zydusX3/CTv1/README.md

# CTv2
Cattle tracker v1: STM32WL (RAK3172) + LoRa + GPS + battery/solar collar tags, a home
beacon (LoRa → WiFi gateway) and a handheld beacon for finding animals in the field.

| Doc | Contents |
|---|---|
| [**Task list**](TASKS.md) | What's done, next and dropped. Updated as we go |
| [01 · System overview](docs/01-system-overview.md) | Block diagrams, radio settings, packet format, power budget |
| [02 · Collar tag](docs/02-hardware-collar-tag.md) | Schematic, BOM, firmware outline |
| [03 · Home beacon](docs/03-hardware-home-beacon.md) | Schematic, BOM, gateway software |
| [04 · Handheld beacon](docs/04-hardware-handheld.md) | Schematic, BOM, screen behaviour |
| [05 · Expansion](docs/05-expansion.md) | Add-ons for each device and the app |
| [06 · App requirements](docs/06-app-requirements.md) | Map, geofence and alert requirements, stack, data model |
| [UI mockup](app/mockup/index.html) | Open in a browser: Simple view (map only, big zoom buttons) and Advanced view (herd, alerts, fence editing) |
| [Hardware reference](hardware/README.md) | Plug-in ports, bench wiring, reference schematics and PCB placements for all three boards |
| [Firmware](firmware/README.md) | Collar tag, home beacon (RAK3172 radio + ESP32-S3 WiFi/MQTT) and handheld, shared library with unit tests, bench monitor |
