zydusX3/CTv1/hardware/beacon/netlist.csv

net | ref | pin
3V3 | C1 | 1
3V3 | C2 | 1
3V3 | J5 | 2 3V3
3V3 | J6 | 1 3V3
3V3 | M1 | 3V3 (out)
3V3 | R7 | 2
3V3 | R8 | 2
3V3 | TP1 | 3V3
3V3 | U1 | VDD
BOOT0 | J6 | 5 BOOT0
BOOT0 | R9 | 1
BOOT0 | U1 | BOOT0
GND | C1 | 2
GND | C2 | 2
GND | D1 | K
GND | D2 | K
GND | J1 | 2 GND
GND | J4 | 2 GND
GND | J5 | 1 GND
GND | J6 | 2 GND
GND | M1 | GND
GND | M2 | GND
GND | Q1 | S
GND | R2 | 2
GND | R6 | 2
GND | R9 | 2
GND | TP1 | GND
GND | U1 | GND
LED1_A | D1 | A
LED1_A | R3 | 2
LED2_A | D2 | A
LED2_A | R4 | 2
LED_ALARM | M1 | GPIO5
LED_ALARM | R4 | 1
LED_RX | M1 | GPIO4
LED_RX | R3 | 1
LINK_RX | M1 | GPIO18 RX1
LINK_RX | U1 | PB6 / TX1
LINK_TX | M1 | GPIO17 TX1
LINK_TX | U1 | PB7 / RX1
NRST | J6 | 6 NRST
NRST | M1 | GPIO16
NRST | U1 | RST
RADIO_IRQ | M1 | GPIO15
RADIO_IRQ | U1 | PA0
RX2 | J6 | 3 RX2
RX2 | U1 | PA3 / RX2
SCL | J5 | 3 SCL
SCL | M1 | GPIO9 SCL
SCL | R8 | 1
SDA | J5 | 4 SDA
SDA | M1 | GPIO8 SDA
SDA | R7 | 1
SIREN_EN | M1 | GPIO6
SIREN_EN | R5 | 1
SIREN_G | Q1 | G
SIREN_G | R5 | 2
SIREN_G | R6 | 1
SIREN_SW | D3 | A
SIREN_SW | J3 | 2 SW
SIREN_SW | Q1 | D
SWCLK | TP1 | SWCLK
SWCLK | U1 | PA14 SWCLK
SWDIO | TP1 | SWDIO
SWDIO | U1 | PA13 SWDIO
TX2 | J6 | 4 TX2
TX2 | U1 | PA2 / TX2
V12 | D3 | K
V12 | J3 | 1 V+
V12 | J4 | 1 V12
V5 | M1 | 5V
V5 | M2 | OUT+
VBUS_SENSE | M1 | GPIO1 ADC
VBUS_SENSE | R1 | 2
VBUS_SENSE | R2 | 1
VIN5 | J1 | 1 VBAT
VIN5 | M2 | IN+
VIN5 | R1 | 1
