zydusX3/CTv1/hardware/tag/netlist.csv

net | ref | pin
3V3 | C2 | 1
3V3 | C5 | 1
3V3 | C7 | 1
3V3 | D2 | K
3V3 | J3 | 1 3V3
3V3 | J4 | 1 3V3
3V3 | J5 | 1 V+
3V3 | R4 | 2
3V3 | R5 | 2
3V3 | R6 | 1
3V3 | TP1 | 3V3
3V3 | U1 | VDD
3V3 | U2 | VOUT
3V3 | U3 | VIN
ACC_INT | J3 | 5 INT
ACC_INT | U1 | PA0
BATT_SENSE | C3 | 1
BATT_SENSE | R1 | 2
BATT_SENSE | R2 | 1
BATT_SENSE | U1 | PB3 (ADC)
BOOT0 | J4 | 5 BOOT0
BOOT0 | R3 | 1
BOOT0 | U1 | BOOT0
BUZZ | R8 | 1
BUZZ | U1 | PB5
BUZZ_G | Q1 | G
BUZZ_G | R8 | 2
BUZZ_G | R9 | 1
BUZZ_SW | D2 | A
BUZZ_SW | J5 | 2 SW
BUZZ_SW | Q1 | D
GND | C1 | 2
GND | C2 | 2
GND | C3 | 2
GND | C4 | 2
GND | C5 | 2
GND | C6 | 2
GND | C7 | 2
GND | D1 | K
GND | J1 | 2 GND
GND | J2 | 2 GND
GND | J3 | 2 GND
GND | J4 | 2 GND
GND | Q1 | S
GND | R2 | 2
GND | R3 | 2
GND | R9 | 2
GND | TP1 | GND
GND | U1 | GND
GND | U2 | GND
GND | U3 | GND
GPS_EN | U1 | PA8
GPS_EN | U3 | ON
GPS_RXD | J2 | 4 RXD
GPS_RXD | U1 | PB6 / TX1
GPS_TXD | J2 | 3 TXD
GPS_TXD | U1 | PB7 / RX1
LED | R7 | 1
LED | U1 | PA1
LED_A | D1 | A
LED_A | R7 | 2
NRST | J4 | 6 NRST
NRST | U1 | RST
RX2 | J4 | 3 RX2
RX2 | U1 | PA3 / RX2
SCL | J3 | 4 SCL
SCL | R5 | 1
SCL | U1 | PA12 SCL
SDA | J3 | 3 SDA
SDA | R4 | 1
SDA | U1 | PA11 SDA
SWCLK | TP1 | SWCLK
SWCLK | U1 | PA14 SWCLK
SWDIO | TP1 | SWDIO
SWDIO | U1 | PA13 SWDIO
TX2 | J4 | 4 TX2
TX2 | U1 | PA2 / TX2
VBAT | C1 | 1
VBAT | J1 | 1 VBAT
VBAT | R1 | 1
VBAT | U2 | VIN
VBCKP | C4 | 1
VBCKP | J2 | 5 VBCKP
VBCKP | R6 | 2
VGPS | C6 | 1
VGPS | J2 | 1 VGPS
VGPS | U3 | VOUT
