zydusX3/CTv1/firmware/gateway_radio/config.h

#pragma once
// Home beacon radio. Farm key, frequency, SF and power must match the tags. These are defaults:
// set them with ATC+CTKEY / ATC+CTFREQ / ATC+CTSF / ATC+CTPWR on UART2 and they are kept in flash.
#define DEFAULT_FARM_KEY {0x43, 0x54, 0x76, 0x31, 0x2d, 0x63, 0x68, 0x61, 0x6e, 0x67, 0x65, 0x2d, 0x6d, 0x65, 0x21, 0x21}
#define DEFAULT_FREQ_HZ 865062500
#define DEFAULT_SF 10              // SF10: ~5 km with the roof antenna (SF9 ~2-4 km, SF11 for hills)
#define DEFAULT_TX_DBM 20          // India 865-867 MHz allows up to 1 W (30 dBm); use 14 in EU868

#define LORA_BW_KHZ 125
#define LORA_CR 0
#define LORA_PREAMBLE 8

#define ACK_DELAY_MS CTV1_ACK_DELAY_MS  // give the tag time to switch to receive after it finishes sending
#define MAX_TAGS 64          // tags remembered for duplicate detection and queued commands
#define STATUS_EVERY_MS 60000

// Where the line protocol goes (see lib/ctv1/src/ctv1_gwlink.h):
//   0 = UART1 (PB6/PB7) to the ESP32-S3, as in docs/03-hardware-home-beacon.md
//   1 = UART2, the USB programming port: plug the module into a PC and run tools/gw_monitor.py
//       (ATC+ commands are off in this mode; the defaults above are used unless set before)
#define LINK_ON_USB 1
#define LINK_BAUD 115200
