zydusX3/CTv1/(commit log)

2026-10-21 Add v1 design docs: block diagrams, schematics, expansion, app requirements and UI mockup
    Claude-Session: https://claude.ai/code/session_01JAYTGVegW8s75dPQkkojPH
2026-10-21 Add Simple view (map only, big zoom controls) with switch to Advanced view
    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
2026-10-21 Start firmware: shared CTv1 library with tests, collar tag and home beacon radio sketches
    - lib/ctv1: packet encode/decode with AES-CMAC MIC, per-tag keys derived
    from one farm key, NMEA GGA/RMC parser, geofence with hysteresis,
    battery curve, report scheduling, beacon UART line protocol
    - tag: GPS fix, LIS3DH motion count, uplink with ACK + one retry,
    buzz / interval / fast-track commands, RTC timer + sleep
    - gateway_radio: continuous RX, MIC check, duplicate detection,
    per-tag command queue, ACKs, text lines to ESP32 or PC
    - tools/gw_monitor.py: decode beacon output and send commands
    - test: 117 host checks incl. FIPS-197 and RFC 4493 vectors
    - docs: packet table and beacon UART wi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
    [config.h, gateway_radio.ino, gw_monitor.py, tag.ino]
2026-10-21 Home beacon ESP32-S3 firmware: WiFi setup, MQTT bridge, offline buffer, backup fence alarm
    - beacon_esp32: setup hotspot with captive settings page, MQTT publish of
    decoded reports / status / events, commands and retained fence from
    MQTT, 2000-report RAM buffer replayed with original timestamps,
    local fence check driving siren + red LED, BOOT button to silence,
    local web page with herd table and Buzz buttons, radio watchdog,
    mains power monitor
    - lib/ctv1: JSON for MQTT (report, command, fence) with host tests
    (153 checks)
    - docs: MQTT topic table and beacon software section match the code
    Claude-Session: https://claude.ai/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
    [beacon.h, beacon_esp32.ino, config.h, herd.cpp, mqtt.cpp, radio.cpp, settings.cpp]
2026-10-21 Map UI: full daily route in Simple view, double-tap zoom
    - Simple view: tapping a cow draws its whole route for today with
    2-hour time marks, a start marker and a card with distance walked
    - Advanced view: selected cow shows the full day, distance walked in
    its card; All trails shows everyone's last 2 h
    - Double-tap zooms in (pinch and one-finger pan already worked)
    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
2026-10-21 Firmware: settings in flash, GPS power saving, handheld beacon
    - Settings (ID, farm key, frequency, SF, power, interval, compass
    calibration) kept in RAK3172 flash with CRC; ATC+CT* commands set them,
    so one build fits every collar. Used by tag, beacon radio and handheld
    - GPS: skip while the animal is still, back off after repeated failed
    fixes, always fix when outside / fast-tracking; UBX config so the
    MAX-M10S only sends GGA + RMC. New 'still' report flag
    - Handheld: listens to all collars, arrow + distance with tilt-compensated
    LSM303AGR compass and calibration, buzz / fast-track sent in the
    collar's receive window at +400 ms; own SH1106/SSD1306 driver and
    screens in the sh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
    [buttons.h, config.h, gateway_radio.ino, gw_monitor.py, handheld.ino, oled.h, tag.ino]
2026-10-22 Decisions D-1..D-5, hardware reference set, India radio defaults
    - hardware/: modular carrier boards with standard plug-in ports
    (GPS-6, SNS-5, DSP-4, BAT-2, DBG-6, OUT-2); bench wiring with
    breakouts, reference schematics, PCB placements, netlists and BOMs
    for tag, beacon and handheld, generated from hardware/gen/boards.py
    and checked against the firmware pin definitions
    - Firmware defaults for India / 5 km: SF10, 20 dBm; reply timing per
    spreading factor so beacon ACK and handheld command never overlap
    (ctv1_lora_airtime_ms, ctv1_handheld_reply_delay_ms,
    ctv1_tag_rx_window_ms); 244 host checks
    - docs/06: v1 runs without a server, the home beacon is the hub;
    server becomes a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
    [bom.csv, netlist.csv]
